eviallet/FPGHat/README.md

# FPGHat
 iCE40 FPGA & STM32 MCU project
