eviallet/FPGHat/hardware/FPGHat.kicad_pcb

## KiCad design hardware/FPGHat.kicad_pcb (2023-05-02)

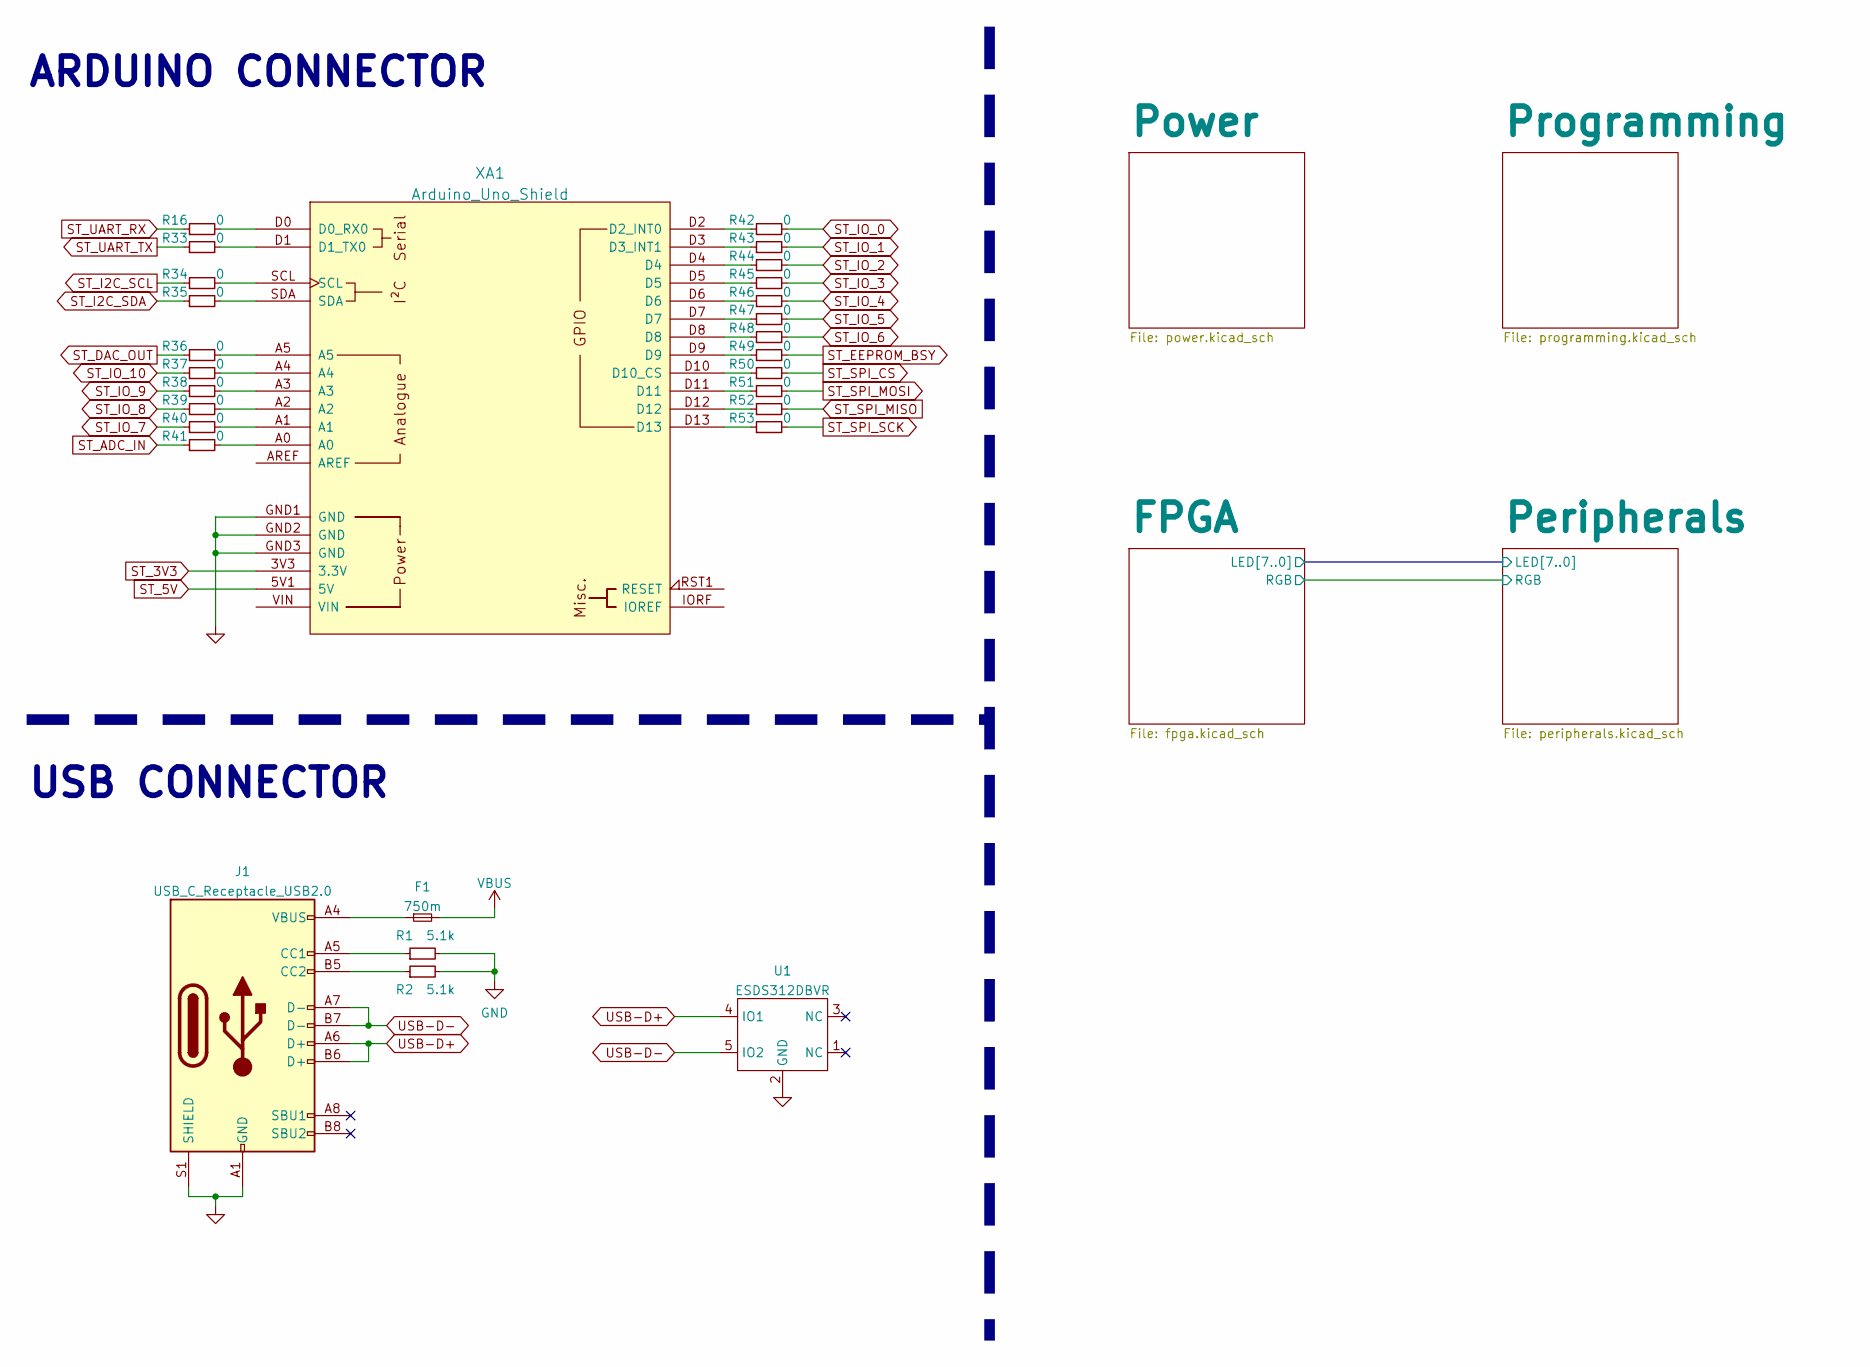
[picture p1: schematic FPGHat.kicad_sch]

Parts:
F1: 750m; Fuse_0603_1608Metric
J1: USB_C_Receptacle_USB2.0; USB_C_Molex_216990-0002
R1, R2: 5.1k; R_0402_1005Metric
R16, R33, R34, R35, R36, R37, R38, R39, R40, R41, R42, R43, R44, R45, R46, R47, R48, R49, R50, R51, R52, R53: 0; R_0402_1005Metric
U1: ESDS312DBVR; SOT-23-5
XA1: Arduino_Uno_Shield; Arduino_Uno_Custom_Hat

Connections:
FPGA_I2C_SCL: R34.1; also elsewhere on the board
FPGA_I2C_SDA: R35.1; also elsewhere on the board
GND: J1.A1 (GND), J1.A12 (GND), J1.B1 (GND), J1.B12 (GND), J1.S1 (SHIELD), R1.2, R2.2, U1.2 (GND), XA1.GND1 (GND), XA1.GND2 (GND), XA1.GND3 (GND); also elsewhere on the board
unnamed: F1.1, J1.A4 (VBUS), J1.A9 (VBUS), J1.B4 (VBUS), J1.B9 (VBUS)
unnamed: J1.A5 (CC1), R1.1
unnamed: J1.B5 (CC2), R2.1
unnamed: R16.2, XA1.D0 (D0_RX0)
unnamed: R33.2, XA1.D1 (D1_TX0)
unnamed: R34.2, XA1.SCL
unnamed: R35.2, XA1.SDA
unnamed: R36.2, XA1.A5
unnamed: R37.2, XA1.A4
unnamed: R38.2, XA1.A3
unnamed: R39.2, XA1.A2
unnamed: R40.2, XA1.A1
unnamed: R41.2, XA1.A0
unnamed: R42.1, XA1.D2 (D2_INT0)
unnamed: R43.1, XA1.D3 (D3_INT1)
unnamed: R44.1, XA1.D4
unnamed: R45.1, XA1.D5
unnamed: R46.1, XA1.D6
unnamed: R47.1, XA1.D7
unnamed: R48.1, XA1.D8
unnamed: R49.1, XA1.D9
unnamed: R50.1, XA1.D10 (D10_CS)
unnamed: R51.1, XA1.D11
unnamed: R52.1, XA1.D12
unnamed: R53.1, XA1.D13
ST_3V3: XA1.3V3 (3.3V); also elsewhere on the board
ST_5V: XA1.5V1 (5V); also elsewhere on the board
ST_ADC_IN: R41.1; also elsewhere on the board
ST_DAC_OUT: R36.1; also elsewhere on the board
ST_EEPROM_BSY: R49.2; also elsewhere on the board
ST_IO_0: R42.2
ST_IO_1: R43.2; also elsewhere on the board
ST_IO_3: R45.2; also elsewhere on the board
ST_IO_4: R46.2; also elsewhere on the board
ST_IO_5: R47.2; also elsewhere on the board
ST_IO_6: R48.2; also elsewhere on the board
ST_IO_7: R40.1; also elsewhere on the board
ST_IO_8: R39.1
ST_IO_9: R38.1
ST_IO_10: R37.1
ST_SPI_CS: R50.2; also elsewhere on the board
ST_SPI_MISO: R52.2; also elsewhere on the board
ST_SPI_MOSI: R51.2; also elsewhere on the board
ST_SPI_SCK: R53.2; also elsewhere on the board
ST_UART_RX: R16.1; also elsewhere on the board
ST_UART_TX: R33.1; also elsewhere on the board
USB-D+: J1.A6 (D+), J1.B6 (D+), U1.4 (IO1); also elsewhere on the board
USB-D-: J1.A7 (D-), J1.B7 (D-), U1.5 (IO2); also elsewhere on the board
VBUS: F1.2; also elsewhere on the board

Notes on the sheet:
USB CONNECTOR
ARDUINO CONNECTOR

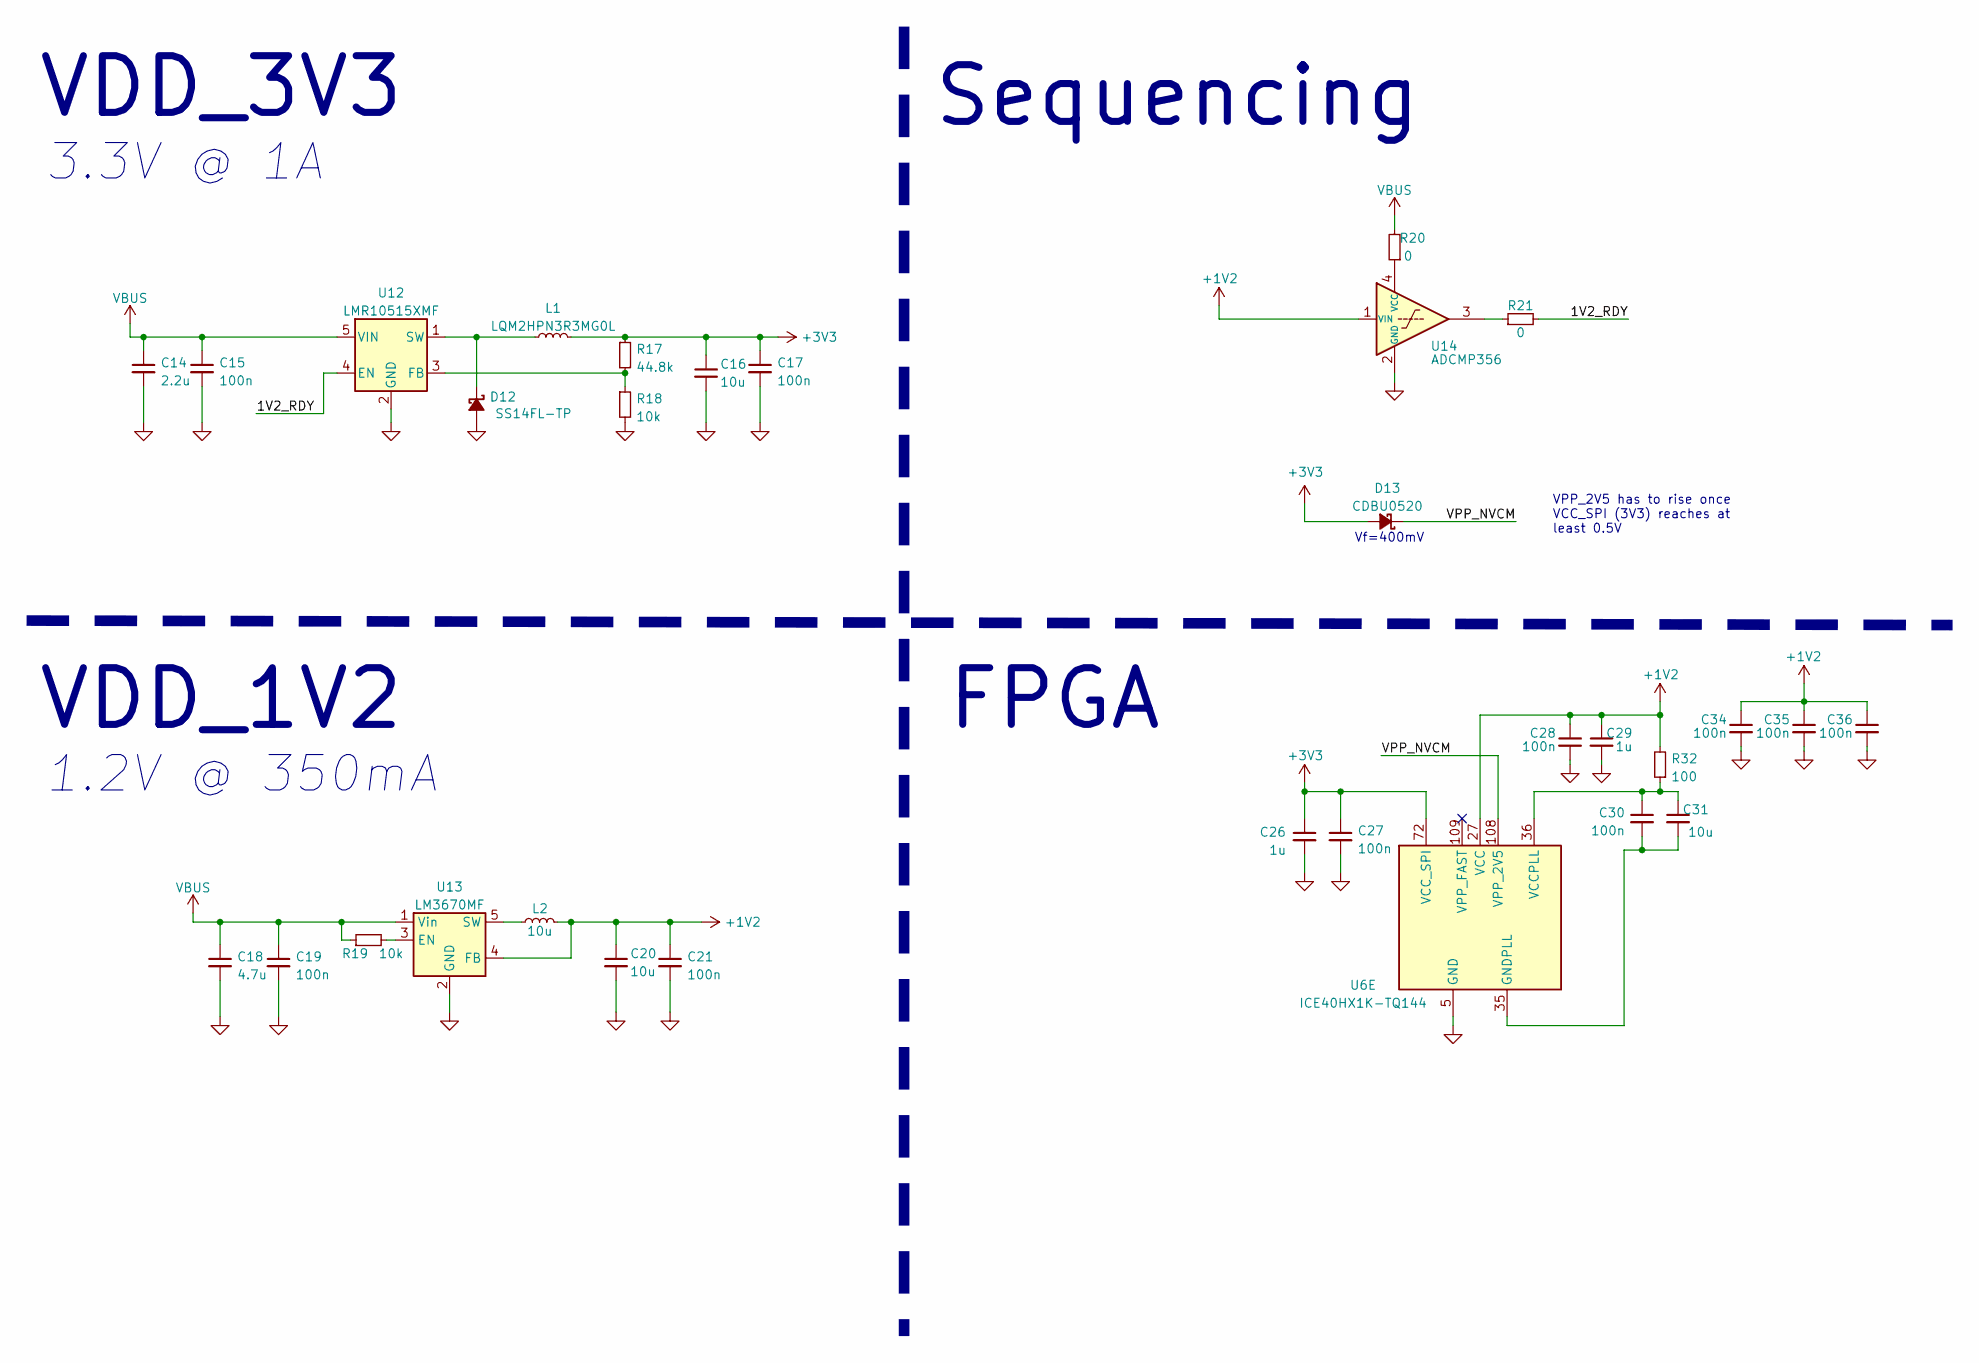
[picture p2: schematic power.kicad_sch]

Parts:
C14: 2.2u; C_1210_3225Metric
C15, C17, C19, C21, C27, C28, C30, C34, C35, C36: 100n; C_0402_1005Metric
C16, C20: 10u; C_1812_4532Metric
C18: 4.7u; C_1210_3225Metric
C26, C29: 1u; C_0603_1608Metric
C31: 10u; C_0603_1608Metric
D12: SS14FL-TP; DO-221AC-2
D13: CDBU0520; D_0603_1608Metric
L1: LQM2HPN3R3MG0L; L_1008_2520Metric
L2: 10u; L_Coilcraft_D01608C
R17: 44.8k; R_0402_1005Metric; Tolerance 0.1%
R18: 10k; R_0402_1005Metric; Tolerance 0.1%
R19: 10k; R_0402_1005Metric
R20, R21: 0; R_0402_1005Metric
R32: 100; R_0402_1005Metric
U6: ICE40HX1K-TQ144; TQFP-144_20x20mm_P0.5mm
U12: LMR10515XMF; SOT-23-5
U13: LM3670MF; TSOT-23-5
U14: ADCMP356; Analog_KS-4

Connections:
+1V2: C20.1, C21.1, C28.1, C29.1, C34.1, C35.1, C36.1, L2.2, R32.2, U6.27 (VCC), U6.51 (VCC), U6.92 (VCC), U6.111 (VCC), U13.4 (FB), U14.1 (VIN)
+3V3: C16.1, C17.1, C26.1, C27.1, D13.2 (A), L1.2, R17.1, U6.72 (VCC_SPI); also elsewhere on the board
/Power/1V2_RDY: R21.2, U12.4 (EN)
/Power/VPP_NVCM: D13.1 (K), U6.108 (VPP_2V5)
GND: C14.2, C15.2, C16.2, C17.2, C18.2, C19.2, C20.2, C21.2, C26.2, C27.2, C28.2, C29.2, C34.2, C35.2, C36.2, D12.2 (A), R18.2, U6.5 (GND), U6.13 (GND), U6.14 (GND), U6.59 (GND), U6.69 (GND), U6.86 (GND), U6.103 (GND), U6.132 (GND), U6.140 (GND), U12.2 (GND), U13.2 (GND), U14.2 (GND); also elsewhere on the board
unnamed: C30.1, C31.1, R32.1, U6.36 (VCCPLL)
unnamed: C30.2, C31.2, U6.35 (GNDPLL)
unnamed: D12.1 (K), L1.1, U12.1 (SW)
unnamed: L2.1, U13.5 (SW)
unnamed: R17.2, R18.1, U12.3 (FB)
unnamed: R19.2, U13.3 (EN)
unnamed: R20.1, U14.4 (VCC)
unnamed: R21.1, U14.3
VBUS: C14.1, C15.1, C18.1, C19.1, R19.1, R20.2, U12.5 (VIN), U13.1 (Vin); also elsewhere on the board

Notes on the sheet:
Sequencing
VDD_1V2
VDD_3V3
Vf=400mV
FPGA
1.2V @ 350mA
VPP_2V5 has to rise once VCC_SPI (3V3) reaches at least 0.5V
3.3V @ 1A

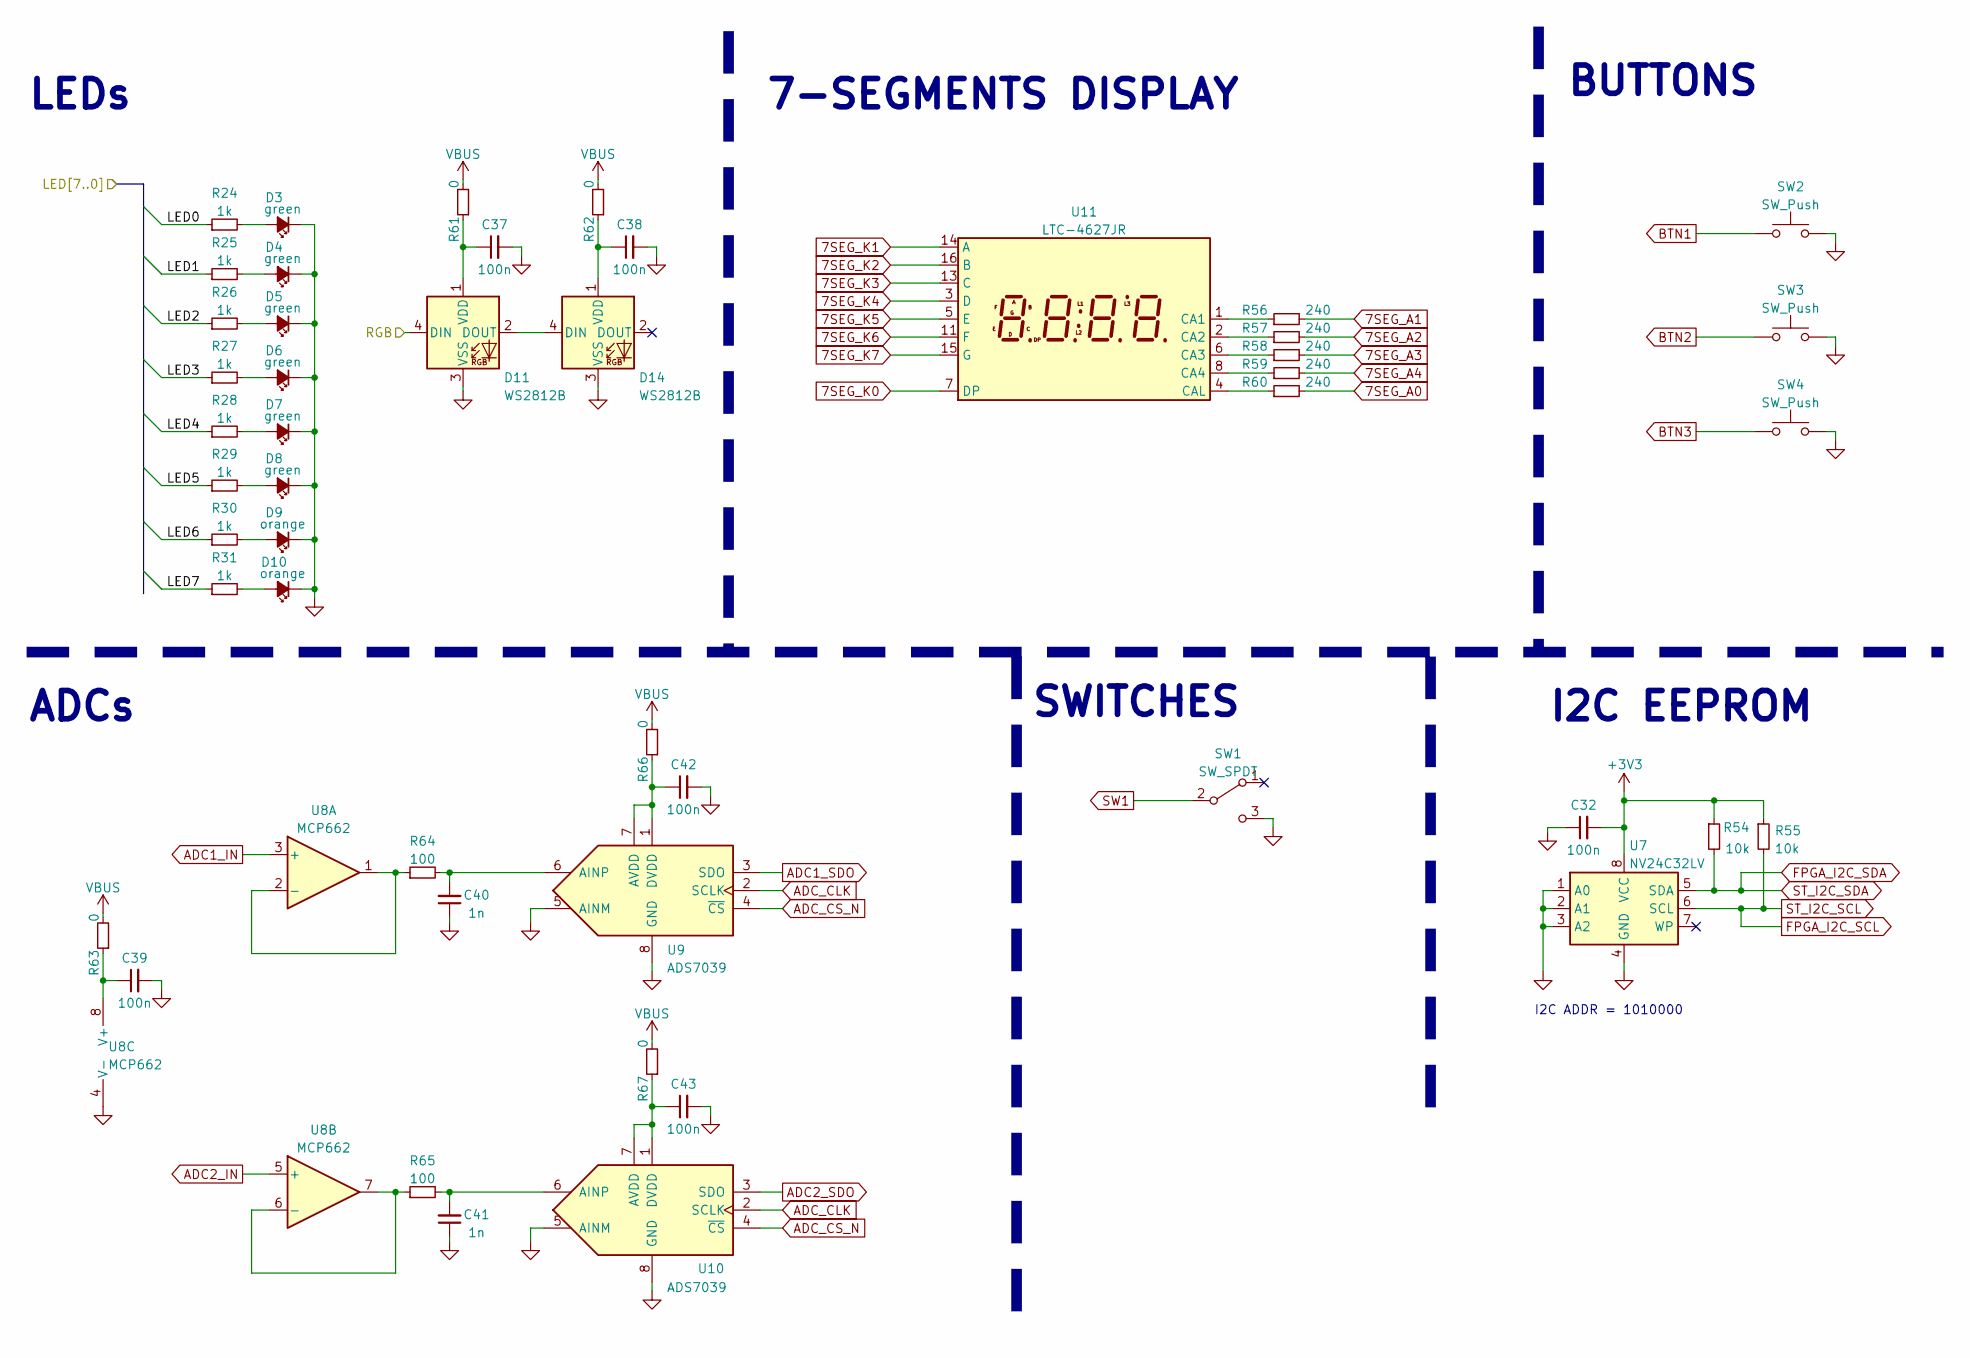
[picture p3: schematic peripherals.kicad_sch]

Parts:
C32, C37, C38, C39, C42, C43: 100n; C_0402_1005Metric
C40, C41: 1n; C_0402_1005Metric
D3, D4, D5, D6, D7, D8: green; LED_0603_1608Metric
D9, D10: orange; LED_0603_1608Metric
D11, D14: WS2812B; LED_WS2812B_PLCC4_5.0x5.0mm_P3.2mm
R24, R25, R26, R27, R28, R29, R30, R31: 1k; R_0402_1005Metric
R54, R55: 10k; R_0402_1005Metric
R56, R57, R58, R59, R60: 240; R_0402_1005Metric
R61, R62, R63, R66, R67: 0; R_0402_1005Metric
R64, R65: 100; R_0402_1005Metric
SW1: SW_SPDT; SW_SPDT_CK-JS102011SAQN
SW2, SW3, SW4: SW_Push; SW_Push_SPST_NO_Alps_SKRK
U7: NV24C32LV; SOIC-8_3.9x4.9mm_P1.27mm
U8: MCP662; SOIC-8_3.9x4.9mm_P1.27mm
U9, U10: ADS7039; VSSOP-8_2.3x2mm_P0.5mm
U11: LTC-4627JR; LTC-4627Jx

Connections:
7SEG_A0: R60.2; also elsewhere on the board
7SEG_A1: R56.2; also elsewhere on the board
7SEG_A2: R57.2; also elsewhere on the board
7SEG_A3: R58.2; also elsewhere on the board
7SEG_A4: R59.2; also elsewhere on the board
7SEG_K0: U11.7 (DP); also elsewhere on the board
7SEG_K1: U11.14 (A); also elsewhere on the board
7SEG_K2: U11.16 (B); also elsewhere on the board
7SEG_K3: U11.13 (C); also elsewhere on the board
7SEG_K4: U11.3 (D); also elsewhere on the board
7SEG_K5: U11.5 (E); also elsewhere on the board
7SEG_K6: U11.11 (F); also elsewhere on the board
7SEG_K7: U11.15 (G); also elsewhere on the board
+3V3: C32.2, R54.1, R55.1, U7.8 (VCC); also elsewhere on the board
/FPGA/LED0: R24.1; also elsewhere on the board
/FPGA/LED1: R25.1; also elsewhere on the board
/FPGA/LED2: R26.1; also elsewhere on the board
/FPGA/LED3: R27.1; also elsewhere on the board
/FPGA/LED4: R28.1; also elsewhere on the board
/FPGA/LED5: R29.1; also elsewhere on the board
/FPGA/LED6: R30.1; also elsewhere on the board
/FPGA/LED7: R31.1; also elsewhere on the board
/FPGA/RGB: D11.4 (DIN); also elsewhere on the board
ADC1_IN: U8.3 (+); also elsewhere on the board
ADC1_SDO: U9.3 (SDO); also elsewhere on the board
ADC2_IN: U8.5 (+); also elsewhere on the board
ADC2_SDO: U10.3 (SDO); also elsewhere on the board
ADC_CLK: U9.2 (SCLK), U10.2 (SCLK); also elsewhere on the board
ADC_CS_N: U9.4 (~CS), U10.4 (~CS); also elsewhere on the board
BTN2: SW3.1; also elsewhere on the board
BTN3: SW4.1; also elsewhere on the board
FPGA_I2C_SCL: R55.2, U7.6 (SCL); also elsewhere on the board
FPGA_I2C_SDA: R54.2, U7.5 (SDA); also elsewhere on the board
GND: C32.1, C37.2, C38.2, C39.2, C40.1, C41.1, C42.2, C43.2, D3.1 (K), D4.1 (K), D5.1 (K), D6.1 (K), D7.1 (K), D8.1 (K), D9.1 (K), D10.1 (K), D11.3 (VSS), D14.3 (VSS), SW1.3 (C), SW2.2, SW3.2, SW4.2, U7.1 (A0), U7.2 (A1), U7.3 (A2), U7.4 (GND), U8.4 (V-), U9.5 (AINM), U9.8 (GND), U10.5 (AINM), U10.8 (GND); also elsewhere on the board
unnamed: C37.1, D11.1 (VDD), R61.1
unnamed: C38.1, D14.1 (VDD), R62.1
unnamed: C39.1, R63.1, U8.8 (V+)
unnamed: C40.2, R64.2, U9.6 (AINP)
unnamed: C41.2, R65.2, U10.6 (AINP)
unnamed: C42.1, R66.1, U9.1 (DVDD), U9.7 (AVDD)
unnamed: C43.1, R67.1, U10.1 (DVDD), U10.7 (AVDD)
unnamed: D3.2 (A), R24.2
unnamed: D4.2 (A), R25.2
unnamed: D5.2 (A), R26.2
unnamed: D6.2 (A), R27.2
unnamed: D7.2 (A), R28.2
unnamed: D8.2 (A), R29.2
unnamed: D9.2 (A), R30.2
unnamed: D10.2 (A), R31.2
unnamed: D11.2 (DOUT), D14.4 (DIN)
unnamed: R56.1, U11.1 (CA1)
unnamed: R57.1, U11.2 (CA2)
unnamed: R58.1, U11.6 (CA3)
unnamed: R59.1, U11.8 (CA4)
unnamed: R60.1, U11.4 (CAL)
unnamed: R64.1, U8.1, U8.2 (-)
unnamed: R65.1, U8.6 (-), U8.7
SW1: SW1.2 (B); also elsewhere on the board
VBUS: R61.2, R62.2, R63.2, R66.2, R67.2; also elsewhere on the board

Notes on the sheet:
BUTTONS
ADCs
I2C ADDR = 1010000
LEDs
I2C EEPROM
7-SEGMENTS DISPLAY
SWITCHES

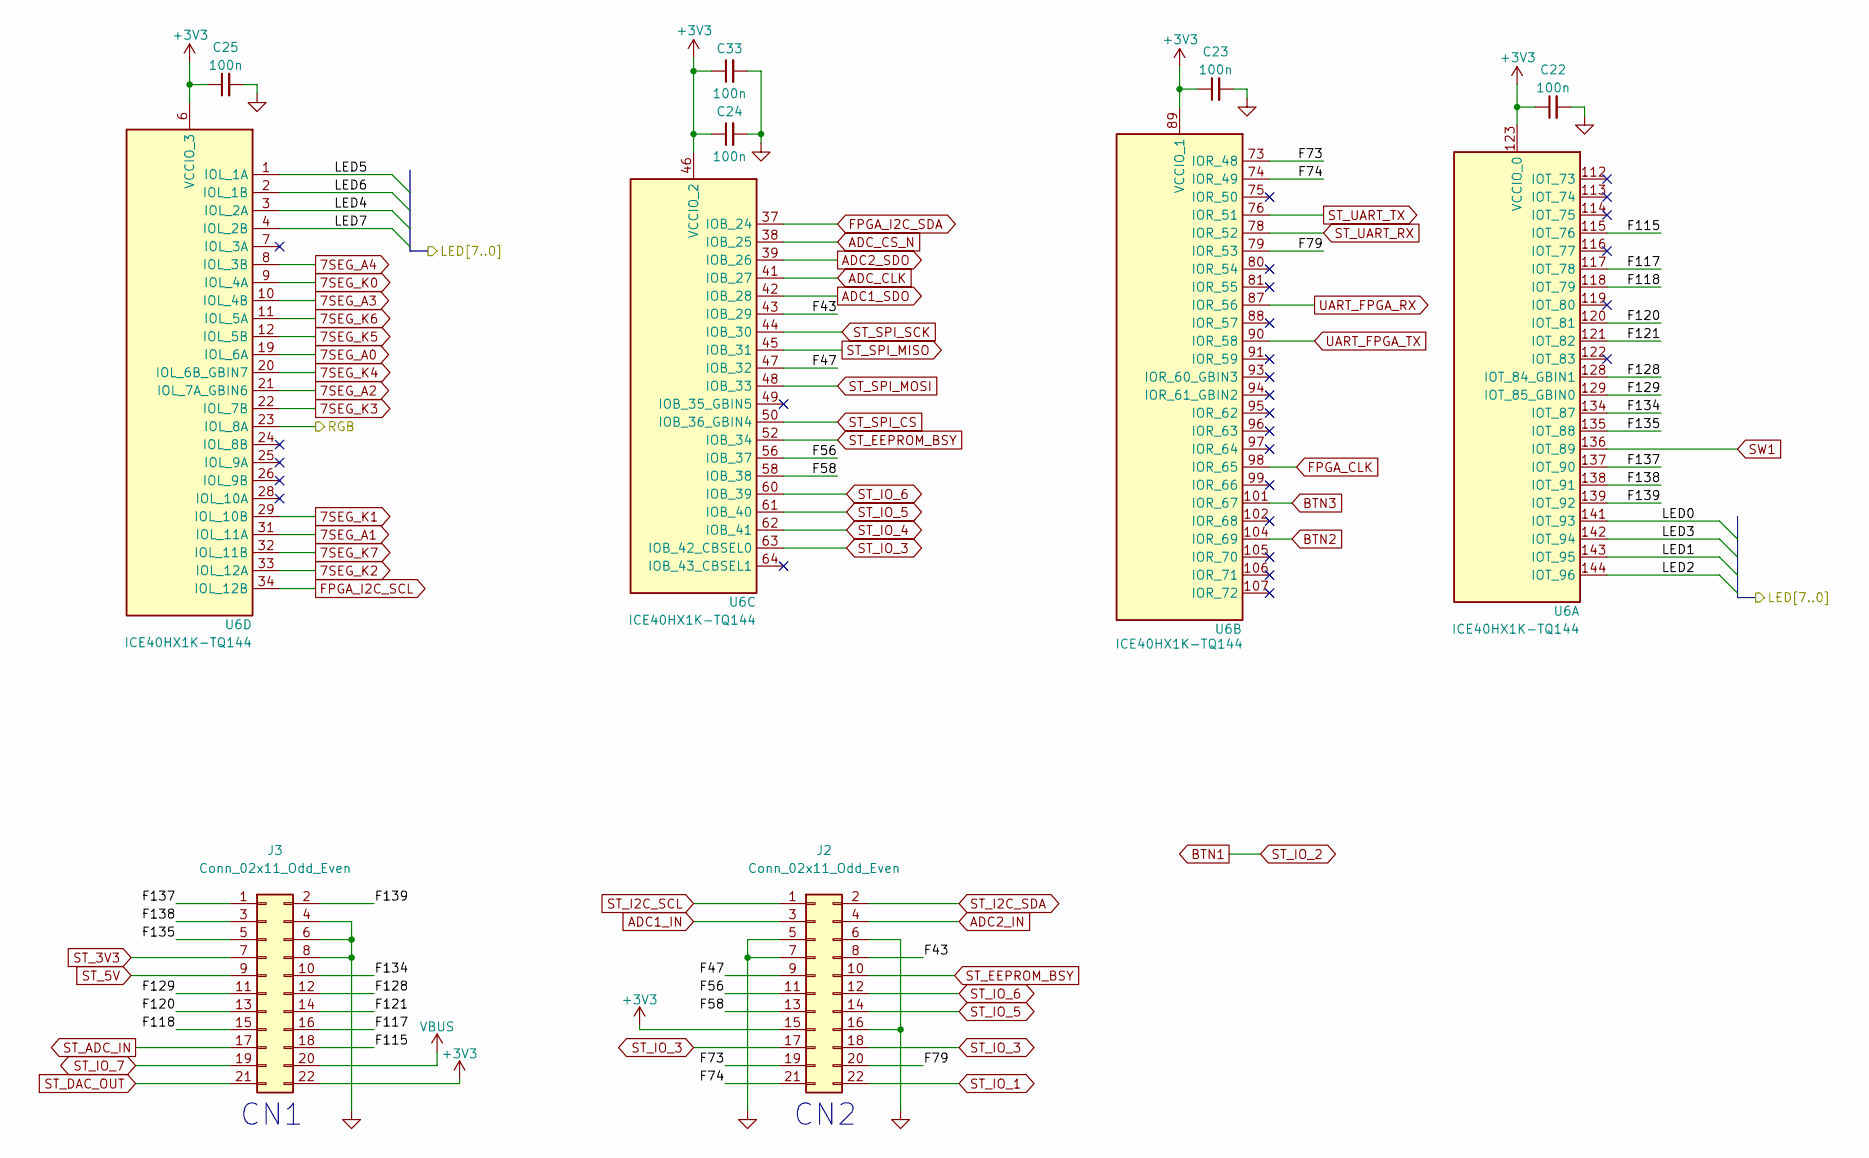
[picture p4: schematic fpga.kicad_sch]

Parts:
C22, C23, C24, C25, C33: 100n; C_0402_1005Metric
J2, J3: Conn_02x11_Odd_Even; PinHeader_2x11_P2.54mm_Vertical_SMD
U6: ICE40HX1K-TQ144; TQFP-144_20x20mm_P0.5mm

Connections:
7SEG_A0: U6.19 (IOL_6A); also elsewhere on the board
7SEG_A1: U6.31 (IOL_11A); also elsewhere on the board
7SEG_A2: U6.21 (IOL_7A_GBIN6); also elsewhere on the board
7SEG_A3: U6.10 (IOL_4B); also elsewhere on the board
7SEG_A4: U6.8 (IOL_3B); also elsewhere on the board
7SEG_K0: U6.9 (IOL_4A); also elsewhere on the board
7SEG_K1: U6.29 (IOL_10B); also elsewhere on the board
7SEG_K2: U6.33 (IOL_12A); also elsewhere on the board
7SEG_K3: U6.22 (IOL_7B); also elsewhere on the board
7SEG_K4: U6.20 (IOL_6B_GBIN7); also elsewhere on the board
7SEG_K5: U6.12 (IOL_5B); also elsewhere on the board
7SEG_K6: U6.11 (IOL_5A); also elsewhere on the board
7SEG_K7: U6.32 (IOL_11B); also elsewhere on the board
+3V3: C22.1, C23.1, C24.1, C25.1, C33.1, J2.15, J3.22, U6.6 (VCCIO_3), U6.30 (VCCIO_3), U6.46 (VCCIO_2), U6.57 (VCCIO_2), U6.89 (VCCIO_1), U6.100 (VCCIO_1), U6.123 (VCCIO_0), U6.133 (VCCIO_0); also elsewhere on the board
/FPGA/F43: J2.8, U6.43 (IOB_29)
/FPGA/F47: J2.9, U6.47 (IOB_32)
/FPGA/F56: J2.11, U6.56 (IOB_37)
/FPGA/F58: J2.13, U6.58 (IOB_38)
/FPGA/F73: J2.19, U6.73 (IOR_48)
/FPGA/F74: J2.21, U6.74 (IOR_49)
/FPGA/F79: J2.20, U6.79 (IOR_53)
/FPGA/F115: J3.18, U6.115 (IOT_76)
/FPGA/F117: J3.16, U6.117 (IOT_78)
/FPGA/F118: J3.15, U6.118 (IOT_79)
/FPGA/F120: J3.13, U6.120 (IOT_81)
/FPGA/F121: J3.14, U6.121 (IOT_82)
/FPGA/F128: J3.12, U6.128 (IOT_84_GBIN1)
/FPGA/F129: J3.11, U6.129 (IOT_85_GBIN0)
/FPGA/F134: J3.10, U6.134 (IOT_87)
/FPGA/F135: J3.5, U6.135 (IOT_88)
/FPGA/F137: J3.1, U6.137 (IOT_90)
/FPGA/F138: J3.3, U6.138 (IOT_91)
/FPGA/F139: J3.2, U6.139 (IOT_92)
/FPGA/LED0: U6.141 (IOT_93); also elsewhere on the board
/FPGA/LED1: U6.143 (IOT_95); also elsewhere on the board
/FPGA/LED2: U6.144 (IOT_96); also elsewhere on the board
/FPGA/LED3: U6.142 (IOT_94); also elsewhere on the board
/FPGA/LED4: U6.3 (IOL_2A); also elsewhere on the board
/FPGA/LED5: U6.1 (IOL_1A); also elsewhere on the board
/FPGA/LED6: U6.2 (IOL_1B); also elsewhere on the board
/FPGA/LED7: U6.4 (IOL_2B); also elsewhere on the board
/FPGA/RGB: U6.23 (IOL_8A); also elsewhere on the board
ADC1_IN: J2.3; also elsewhere on the board
ADC1_SDO: U6.42 (IOB_28); also elsewhere on the board
ADC2_IN: J2.4; also elsewhere on the board
ADC2_SDO: U6.39 (IOB_26); also elsewhere on the board
ADC_CLK: U6.41 (IOB_27); also elsewhere on the board
ADC_CS_N: U6.38 (IOB_25); also elsewhere on the board
BTN2: U6.104 (IOR_69); also elsewhere on the board
BTN3: U6.101 (IOR_67); also elsewhere on the board
FPGA_CLK: U6.98 (IOR_65); also elsewhere on the board
FPGA_I2C_SCL: J2.1, U6.34 (IOL_12B); also elsewhere on the board
FPGA_I2C_SDA: J2.2, U6.37 (IOB_24); also elsewhere on the board
GND: C22.2, C23.2, C24.2, C25.2, C33.2, J2.5, J2.6, J2.7, J2.16, J3.4, J3.6, J3.8; also elsewhere on the board
ST_3V3: J3.7; also elsewhere on the board
ST_5V: J3.9; also elsewhere on the board
ST_ADC_IN: J3.17; also elsewhere on the board
ST_DAC_OUT: J3.21; also elsewhere on the board
ST_EEPROM_BSY: J2.10, U6.52 (IOB_34); also elsewhere on the board
ST_IO_1: J2.22; also elsewhere on the board
ST_IO_3: J2.17, J2.18, U6.63 (IOB_42_CBSEL0); also elsewhere on the board
ST_IO_4: U6.62 (IOB_41); also elsewhere on the board
ST_IO_5: J2.14, U6.61 (IOB_40); also elsewhere on the board
ST_IO_6: J2.12, U6.60 (IOB_39); also elsewhere on the board
ST_IO_7: J3.19; also elsewhere on the board
ST_SPI_CS: U6.50 (IOB_36_GBIN4); also elsewhere on the board
ST_SPI_MISO: U6.45 (IOB_31); also elsewhere on the board
ST_SPI_MOSI: U6.48 (IOB_33); also elsewhere on the board
ST_SPI_SCK: U6.44 (IOB_30); also elsewhere on the board
ST_UART_RX: U6.78 (IOR_52); also elsewhere on the board
ST_UART_TX: U6.76 (IOR_51); also elsewhere on the board
SW1: U6.136 (IOT_89); also elsewhere on the board
UART_FPGA_RX: U6.87 (IOR_56); also elsewhere on the board
UART_FPGA_TX: U6.90 (IOR_58); also elsewhere on the board
VBUS: J3.20; also elsewhere on the board

Notes on the sheet:
CN1
CN2

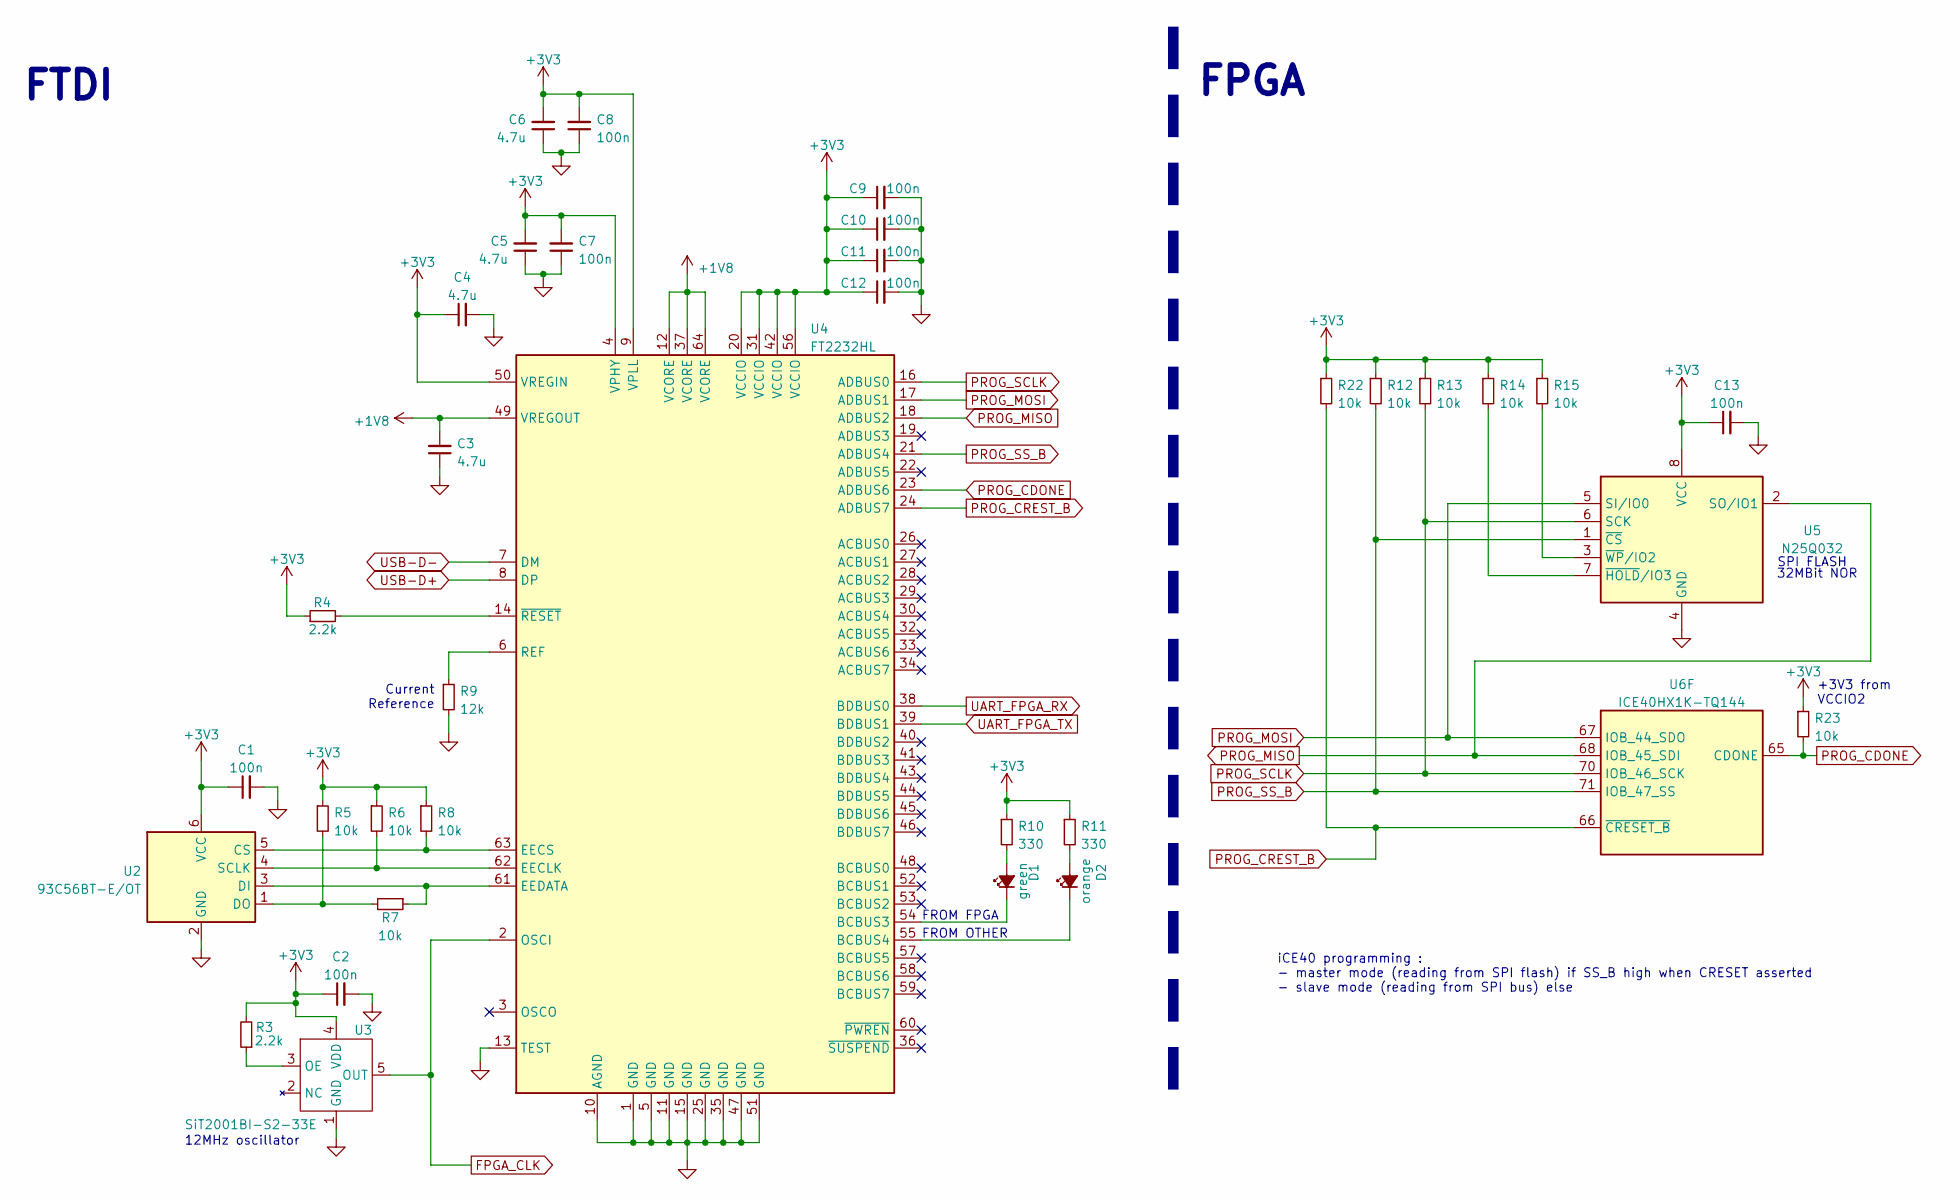
[picture p5: schematic programming.kicad_sch]

Parts:
C1, C2, C7, C8, C9, C10, C11, C12, C13: 100n; C_0402_1005Metric
C3, C4, C5, C6: 4.7u; C_0603_1608Metric
D1: green; LED_0603_1608Metric
D2: orange; LED_0603_1608Metric
R3, R4: 2.2k; R_0402_1005Metric
R5, R6, R7, R8, R12, R13, R14, R15, R22, R23: 10k; R_0402_1005Metric
R9: 12k; R_0402_1005Metric; Tolerance 0.1%
R10, R11: 330; R_0402_1005Metric
U2: 93C56BT-E/OT; SOT-23-6
U3: SiT2001BI-S2-33E; SOT-23-5
U4: FT2232HL; LQFP-64_10x10mm_P0.5mm
U5: N25Q032; SOP2-8
U6: ICE40HX1K-TQ144; TQFP-144_20x20mm_P0.5mm

Connections:
+1V8: C3.2, U4.12 (VCORE), U4.37 (VCORE), U4.49 (VREGOUT), U4.64 (VCORE)
+3V3: C1.1, C2.1, C4.1, C5.2, C6.2, C7.2, C8.2, C9.1, C10.1, C11.1, C12.1, C13.1, R3.2, R4.1, R5.1, R6.1, R8.1, R10.1, R11.1, R12.1, R13.1, R14.1, R15.1, R22.1, R23.1, U2.6 (VCC), U3.4 (VDD), U4.4 (VPHY), U4.9 (VPLL), U4.20 (VCCIO), U4.31 (VCCIO), U4.42 (VCCIO), U4.50 (VREGIN), U4.56 (VCCIO), U5.8 (VCC); also elsewhere on the board
FPGA_CLK: U3.5 (OUT), U4.2 (OSCI); also elsewhere on the board
GND: C1.2, C2.2, C3.1, C4.2, C5.1, C6.1, C7.1, C8.1, C9.2, C10.2, C11.2, C12.2, C13.2, R9.2, U2.2 (GND), U3.1 (GND), U4.1 (GND), U4.5 (GND), U4.10 (AGND), U4.11 (GND), U4.13 (TEST), U4.15 (GND), U4.25 (GND), U4.35 (GND), U4.47 (GND), U4.51 (GND), U5.4 (GND); also elsewhere on the board
unnamed: D1.1 (K), U4.54 (BCBUS3)
unnamed: D1.2 (A), R10.2
unnamed: D2.1 (K), U4.55 (BCBUS4)
unnamed: D2.2 (A), R11.2
unnamed: R3.1, U3.3 (OE)
unnamed: R4.2, U4.14 (~RESET)
unnamed: R5.2, R7.2, U2.1 (DO)
unnamed: R6.2, U2.4 (SCLK), U4.62 (EECLK)
unnamed: R7.1, U2.3 (DI), U4.61 (EEDATA)
unnamed: R8.2, U2.5 (CS), U4.63 (EECS)
unnamed: R9.1, U4.6 (REF)
unnamed: R14.2, U5.7 (~HOLD/IO3)
unnamed: R15.2, U5.3 (~WP/IO2)
PROG_CDONE: R23.2, U4.23 (ADBUS6), U6.65 (CDONE)
PROG_CREST_B: R22.2, U4.24 (ADBUS7), U6.66 (~CRESET_B)
PROG_MISO: U4.18 (ADBUS2), U5.2 (SO/IO1), U6.68 (IOB_45_SDI)
PROG_MOSI: U4.17 (ADBUS1), U5.5 (SI/IO0), U6.67 (IOB_44_SDO)
PROG_SCLK: R13.2, U4.16 (ADBUS0), U5.6 (SCK), U6.70 (IOB_46_SCK)
PROG_SS_B: R12.2, U4.21 (ADBUS4), U5.1 (~CS), U6.71 (IOB_47_SS)
UART_FPGA_RX: U4.38 (BDBUS0); also elsewhere on the board
UART_FPGA_TX: U4.39 (BDBUS1); also elsewhere on the board
USB-D+: U4.8 (DP); also elsewhere on the board
USB-D-: U4.7 (DM); also elsewhere on the board

Notes on the sheet:
Current Reference
32MBit NOR
FTDI
FROM FPGA
12MHz oscillator
FROM OTHER
FPGA
SPI FLASH
iCE40 programming : - master mode (reading from SPI flash) if SS_B high when CRESET asserted - slave mode (reading from SPI bus) else
+3V3 from VCCIO2

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
