eviallet/FPGHat/hardware/FPGHat.kicad_pcb

## KiCad design hardware/FPGHat.kicad_pcb (continued)

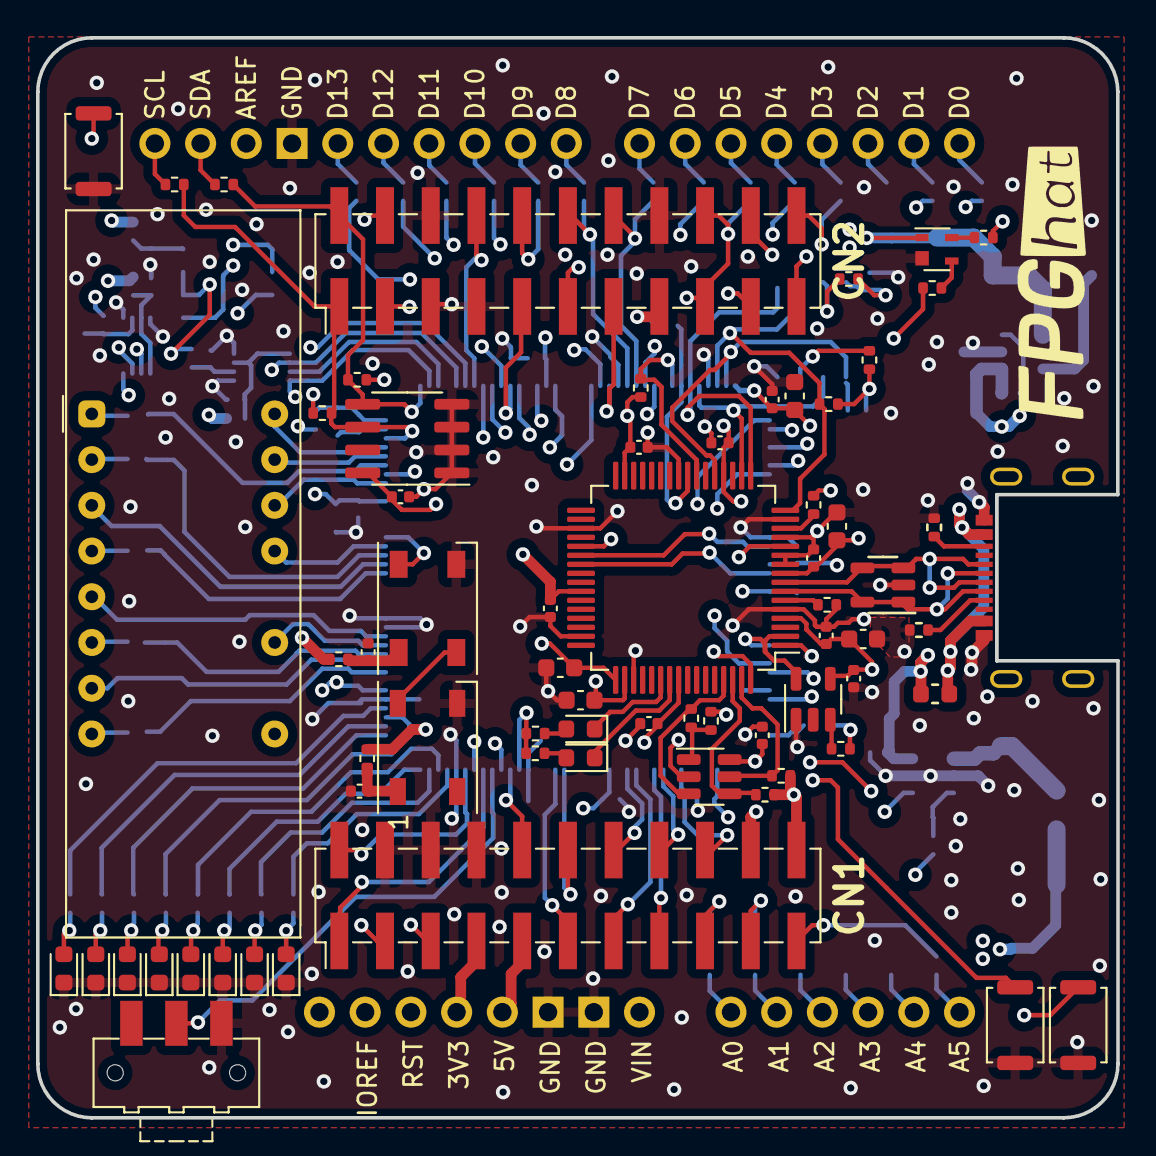
[picture p6: board FPGHat.kicad_pcb from above]

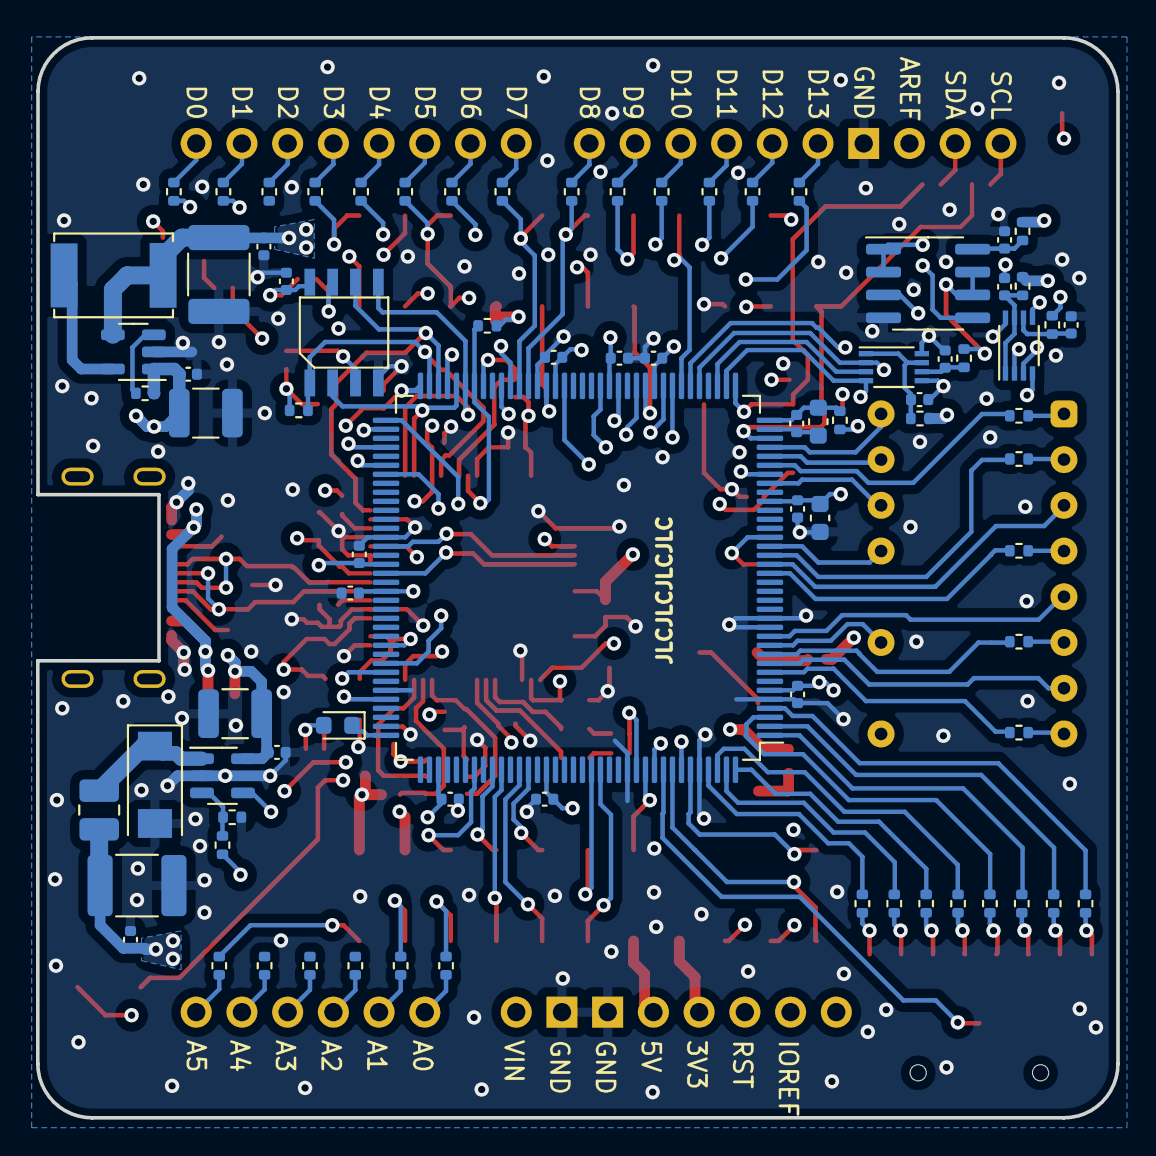
[picture p7: board FPGHat.kicad_pcb from below]

Board: 4 copper layers, 60.0 x 60.0 mm, 149 parts (81 on the bottom side), 157 nets.
