eviallet/FPGHat/fpga/pins.pcf

# main fpga signals
set_io   -pullup yes    nrst        104
set_io                  rclk        98

# leds
set_io                  led0        141
set_io                  led1        143
set_io                  led2        144
set_io                  led3        142
set_io                  led4        3
set_io                  led5        1
set_io                  led6        2
set_io                  led7        4

# switches
set_io   -pullup yes    sw          136
set_io   -pullup yes    btn         101

# uart
set_io                  ftdi_rx     87
set_io                  ftdi_tx     90
set_io                  fpga_rx     76
set_io                  fpga_tx     78

# spi
set_io                  st_spi_sck  44
set_io                  st_spi_sdo  45
set_io                  st_spi_nss  50

# adc
set_io   -pullup yes    adc_ssn     38
set_io                  adc_clk     41
set_io                  adc1_sdo    42
set_io                  adc2_sdo    39

# segments
set_io                  seg_a0      19
set_io                  seg_a1      31
set_io                  seg_a2      21
set_io                  seg_a3      10
set_io                  seg_a4      8
set_io                  seg_k0      9
set_io                  seg_k1      29
set_io                  seg_k2      33
set_io                  seg_k3      22
set_io                  seg_k4      20
set_io                  seg_k5      12
set_io                  seg_k6      11
set_io                  seg_k7      32

# rgb
set_io                  rgb         23

# connectors
# cn1
set_io                  cn1_1       137
set_io                  cn1_2       139
set_io                  cn1_3       138
set_io                  cn1_5       135
set_io                  cn1_10      134
set_io                  cn1_11      129
set_io                  cn1_12      128
set_io                  cn1_13      120
set_io                  cn1_14      121
set_io                  cn1_15      118
set_io                  cn1_16      117
set_io                  cn1_18      115
# cn2
set_io                  cn2_8       43
set_io                  cn2_9       47
set_io                  cn2_11      56
set_io                  cn2_13      58
set_io                  cn2_19      73
set_io                  cn2_20      79
set_io                  cn2_21      74
